piernov/LED_Cube_Arduino/doc/Compte rendu/Sans_titre.jpg

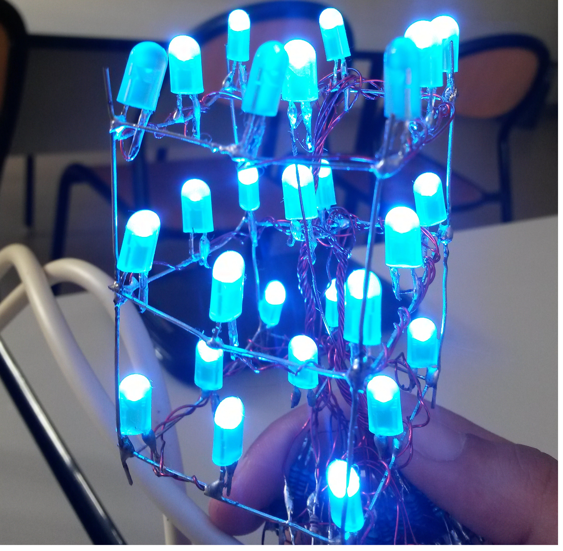
doc/Compte rendu/Sans_titre.jpg
