piernov/LED_Cube_Arduino/doc/Présentation Projet Finale/20160525_165653.jpg

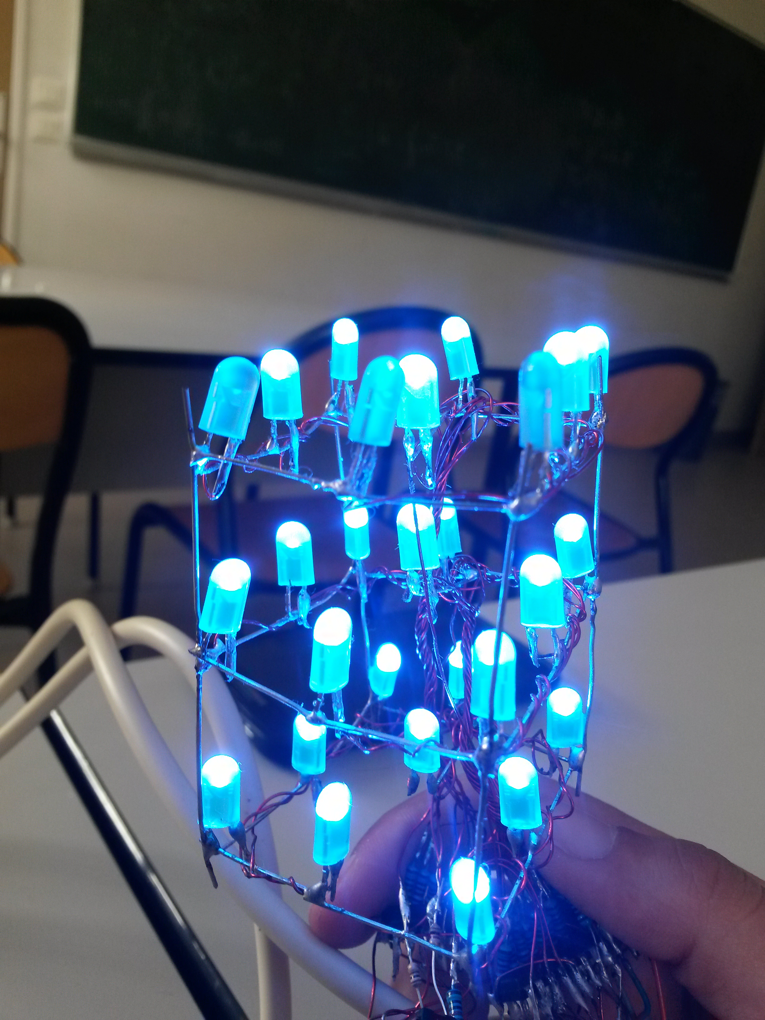
doc/Présentation Projet Finale/20160525_165653.jpg
