piernov/LED_Cube_Arduino/README.md

# LED_Cube_Arduino

Depends on:
	— ShiftRegister74HC595 library: https://github.com/Simsso/Shift-Register-74HC595-Arduino-Library.git
