piernov/LED_Cube_Arduino/doc/Présentation Projet Finale/Présentation projet.tex

\documentclass{beamer}
\usepackage{luatextra}
\usepackage{polyglossia}
\usepackage{ulem}
\usepackage{framed}
\usepackage{color}
\usepackage{geometry}
\usepackage{amsmath}
\usepackage{unicode-math}
\usepackage{hyperref}

\usepackage{ifluatex}
\ifluatex
  \usepackage{pdftexcmds}
  \makeatletter
  \let\pdfstrcmp\pdf@strcmp
  \let\pdffilemoddate\pdf@filemoddate
  \makeatother
\fi
\usepackage{svg}

%%\setmathfont{xits-math.otf}

\setmainlanguage{french}
\setmainfont{Latin Modern Roman}

%%\geometry{margin={1in,1in}}

\newcommand\image[2]{
\directlua{
local image = img.scan({filename = "#1"})

image.height = image.height * #2
image.width  = image.width  * #2

node.write(img.node(image))
}
}

\usetheme{Madrid}

\title{Présentation projet TP électronique}
\author{Julia OUZZINE - Pierre-Emmanuel NOVAC}

%\institute{\image{polytechnice.png}{0.05}}
\date{\today}

\begin{document}

\begin{frame}
  \maketitle
\end{frame}

%%\makeatletter
\begin{frame}
\frametitle{Cube de DELs}
\image{Sans_titre.png}{0.1}
%%  \tiny \textit{Source: Mitch Altman — CC-BY-SA — flickr.com}
\end{frame}
%%\makeatother

\begin{frame}
  \frametitle{Fonctionnalités}
  \begin{itemize}
    \item Contrôle indépendant de 27 DELs
    \item Différentes animations préprogrammées
    \item Choix de l'animation à l'aide d'une application Android (transmission Bluetooth)
    \item \sout{Détection de l'orientation et réaction en conséquence}
    \item \sout{Interaction avec l'environnement: capteur de contact (ou capteur sonore)}
  \end{itemize}
\end{frame}

\begin{frame}
  \frametitle{Composants utilisés}
  \begin{itemize}
    \item 1 microcontrôleur: Arduino
    \item 27 DELs bleues
    \item 4 registres à décalages 74HC595N
    \item 1 module bluetooth: HC-06
    \item 1 accéléromètre: ADXL335
  \end{itemize}
\end{frame}

\begin{frame}
  \frametitle{Animations — Démonstration}
\end{frame}

\begin{frame}
  \frametitle{Schéma fonctionnel}
  \includesvg{block_diagram}
\end{frame}

\begin{frame}
  \frametitle{Contrôle des LED — Registre à décalage — Cablâge}
  \includesvg{sn74hc595_dip_pinout}
\end{frame}

\begin{frame}
  \frametitle{Améliorations possibles}
  \begin{itemize}
    \item Cube 8x8x8 LEDs
    \item Capteur de contact
    \item Apparence: boîte, masquer les câbles, etc…
    \item Plus d'animations
  \end{itemize}
\end{frame}

\begin{frame}
  \frametitle{Conclusion}
\end{frame}

\begin{frame}
  \frametitle{Ressources}
  \begin{itemize}
    \item \url{https://www.arduino.cc/en/Tutorial/ShiftOut}
    \item ShiftRegister74HC595: \url{https://github.com/Simsso/Shift-Register-74HC595-Arduino-Library}
    \item Code source: \url{https://github.com/piernov/LED_Cube_Arduino}
  \end{itemize}
\end{frame}

\end{document}
