piernov/LED_Cube_Arduino/doc/Présentation Projet/Présentation projet.pdf

# Présentation projet TP électronique

# Julia OUZZINE - Pierre-Emmanuel NOVAC

# 29 avril 2016

Julia OUZZINE - Pierre-Emmanuel NOVAC | Présentation projet TP électronique | 29 avril 2016 | 1 / 7

# Cube de DELs

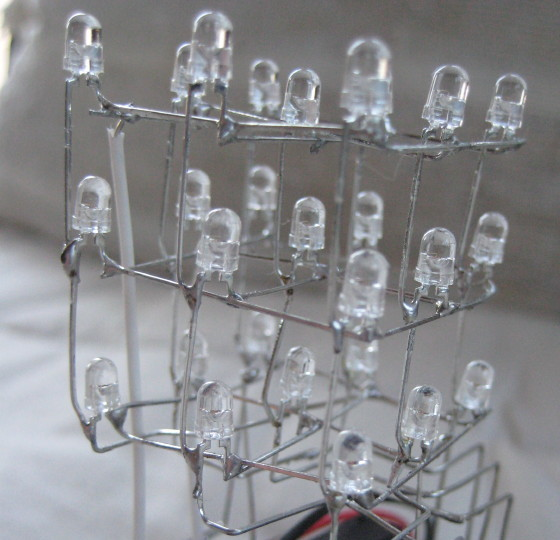
[picture p6: figure]

Source : Mitch Altman — CC-BY-SA — flickr.com

Julia OUZZINE - Pierre-Emmanuel NOVAC | Présentation projet TP électronique | 29 avril 2016 | 2 / 7

# Pourquoi ?

Julia OUZZINE - Pierre-Emmanuel NOVAC | Présentation projet TP électronique | 29 avril 2016 | 3 / 7

# Fonctionnalités

# Contrôle indépendant de 27 DELs Différentes animations préprogrammées Choix de l’animation à l’aide d’une application Android (transmission Bluetooth) Détection de l’orientation et réaction en conséquence Interaction avec l’environnement : capteur de contact (ou capteur sonore)

Julia OUZZINE - Pierre-Emmanuel NOVAC | Présentation projet TP électronique | 29 avril 2016 | 4 / 7

# Composants utilisés

# 1 microcontrôleur : Arduino 27 DELs bleues 2 Contrôleur de LED : TI TLC5940 1 module bluetooth : HC-06 1 accéléromètre : ADXL335

Julia OUZZINE - Pierre-Emmanuel NOVAC | Présentation projet TP électronique | 29 avril 2016 | 5 / 7

# Schéma fonctionnel

# Bluetooth module

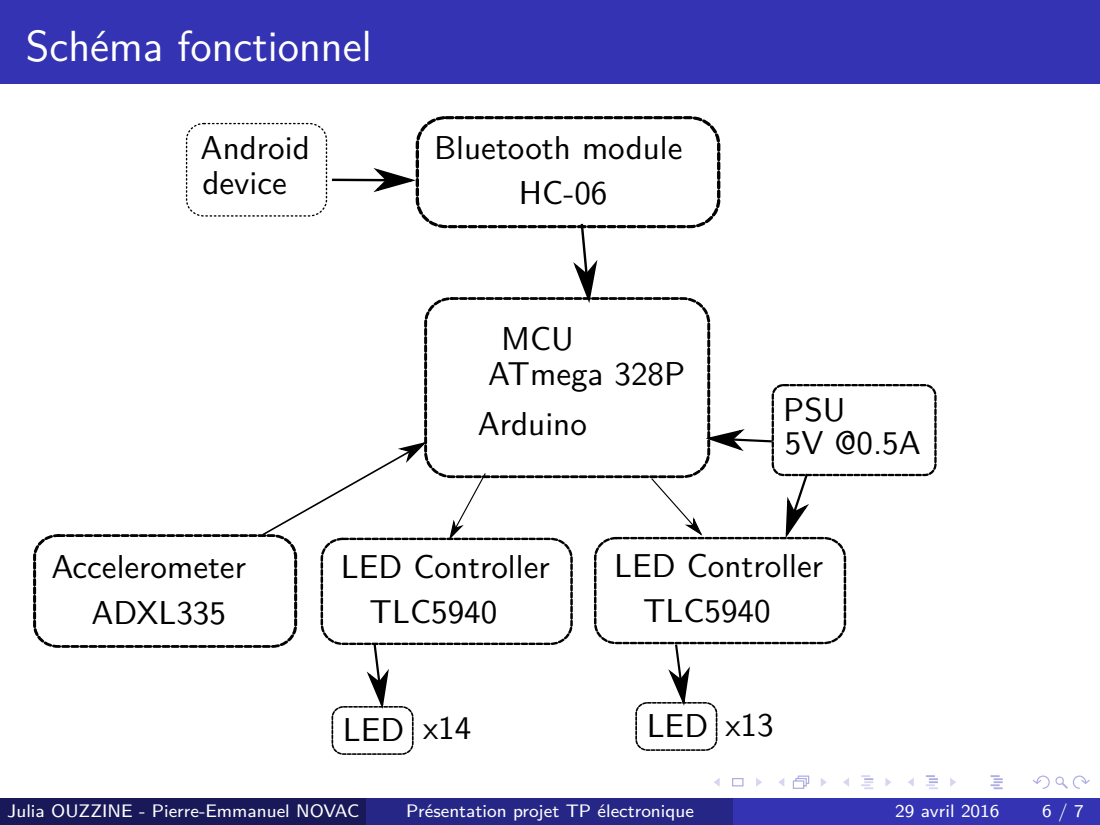
[picture p7: page 6]
MCU; Arduino; ATmega 328P; Accelerometer ADXL335; LED Controller TLC5940; Android device; LED x14; LED x13; PSU 5V @0.5A; Julia OUZZINE - Pierre-Emmanuel NOVAC; Présentation projet TP électronique; 29 avril 2016

# Consommation électrique — Alimentation

### 27 DELs 20mA : 27 × 20 = 540mA

# Arduino : ≈ 50mA

### 2 TLC5940 : 2 × 12 = 24mA

# HC-06 : 8mA ADXL335 : 0, 35mA

≈ 652mA
USB : 5V — 500mA max.
Julia OUZZINE - Pierre-Emmanuel NOVAC | Présentation projet TP électronique | 29 avril 2016 | 7 / 7
