piernov/LED_Cube_Arduino/doc/Compte rendu/sn74hc595_dip_pinout.pdf

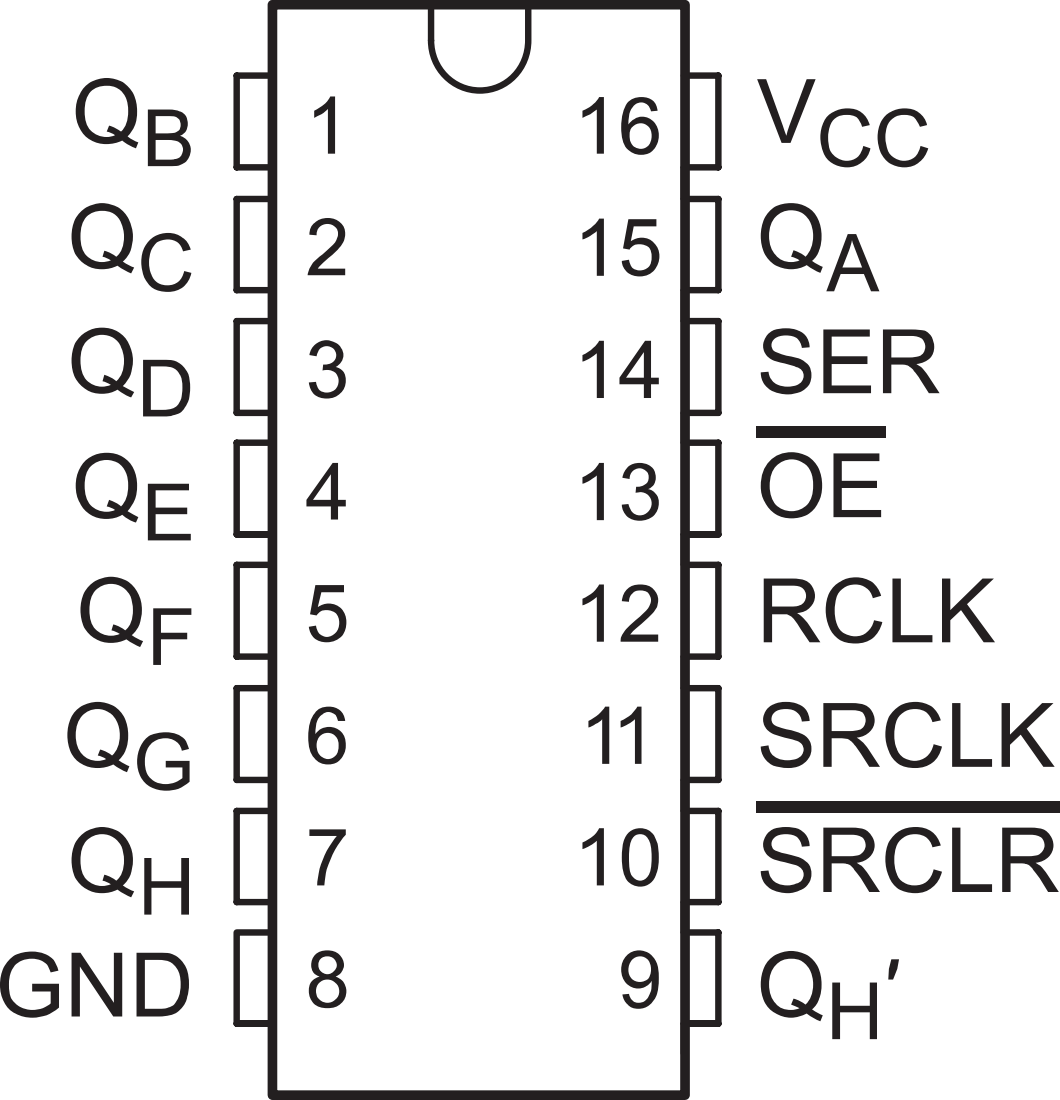
[picture p8: page 1]
