piernov/LED_Cube_Arduino/doc/Compte rendu/cube_floor.pdf

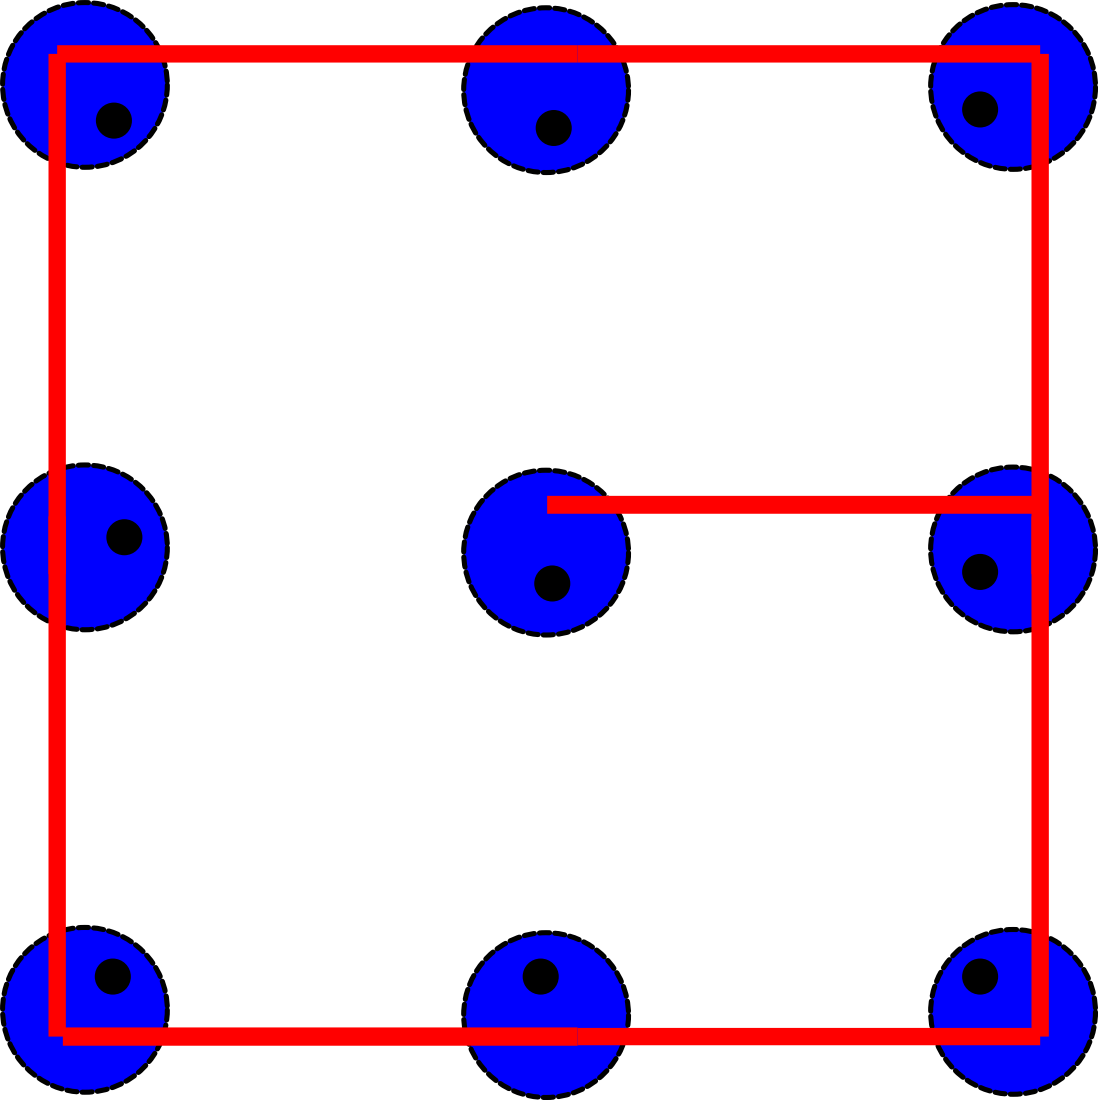
[picture p9: page 1]
