piernov/LED_Cube_Arduino/(commit log)

2016-05-20 Starts Bluetooth support + various fixes
    [Animation.cpp, Animation.h, Bluetooth.cpp, Bluetooth.h, LED_Cube_Arduino.ino]
2016-05-26 As they said, dynamic allocation on Arduino is a bad idea + somewhat finish Bluetooth + start Accelerometer
2016-05-27 Fixes for accelerometer
2016-05-27 Add distance sensor
2016-05-29 Add doc + LED_Cube.kwl
